servgi/pH-Box-Spring-2025/README.md

Welcome to my pH box project! This is a collection of some of the most significant rescources and products I've used and produced thus far. You can contact me at s.serviagi@gmail.com or gservia@msudenver.edu. Thanks!
