servgi/pH-Box-Spring-2025/2025 URC poster.pdf

# Utilizing Simple Technology to Create an Instrument for Improved pH Measurements

# Grace Servia, Dr. Shailesh Ambre Metropolitan State University of Denver Department of Chemistry and Biochemistry

`

## Background

Hole for on/off
switch with tactile
labels

USB-C port to
easily access QT Py
and code

Sliding drawer
with battery
compartment

Grooves for QT Py and
Audio BFF to sit in

Speaker mount

Grate for sound to
travel through

Holes for wiring
Detector mount

Cuvette Platform

Indicates direction
of detector

Slot for cuvette

Flip cap to enclose
dark chamber

Ridged and tapered lid to
enclose all chambers

## The Grace pH Box Conclusions and Next Steps

## Acknowledgements

## References

Thank you to Dr. Ambre for supporting my idea and giving me a platform to do research. Thank you also to my big brother Jack for letting me borrow his supplies and knowledge. Thanks to the entire MSU Denver Chemistry and Biochemistry department for teaching me, supporting me, sparking my interest in these subjects, and encouraging me every day.

1) 8.6: The pH Concept. Chemistry LibreTexts. https://chem.libretexts.org/Bookshelves/Introductory_Chemistry/Chemistry_for_Allied_Health_(Soult)/08%3A_Properties_ of_Solutions/8.06%3A_The_pH_Concept (accessed 2024-04-25).
2) 6. Acid-Base Indicators. Chemistry LibreTexts. https://chem.libretexts.org/Bookshelves/Physical_and_Theoretical_Chemistry_Textbook_Maps/Supplemental_Modules_(Physical_and_Theoretical_Chemistry)/Equilibria/Acid-Ba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 (accessed 2024-04-25).
3) Amazon.com. https://www.amazon.com/Hydrion-paper-93-Dispenser-Color/dp/B005FYGXUC (accessed 2024-04-25).
4) pH Electrodes. Chemistry LibreTexts. https://chem.libretexts.org/Bookshelves/Analytical_Chemistry/Supplemental_Modules_(Analytical_Chemistry)/Analytical_S ciences_Digital_Library/Courseware/Analytical_Electrochemistry%3A_Potentiometry/05_pH_Electrodes (accessed 2024-04-25).
5) pH Electrode BNC. Vernier. https://www.vernier.com/product/ph-electrode-bnc/ (accessed 2024-04-26).
6) Aristov, M. M.; Moore, J. W.; Berry, J. F. Library of 3D Visual Teaching Tools for the Chemistry Classroom Accessible via Sketchfab and Viewable in Augmented Reality. J. Chem. Educ. 2021, 98 (9), 3032–3037. https://doi.org/10.1021/acs.jchemed.1c00460.
7) American Printing House for the Blind; Hoffmann, R. The SALS App: Making Chemistry Accessible With iOS Devices. JSESD 2019, 22 (1), 1–5. https://doi.org/10.14448/jsesd.11.0005.
8) Kovarik, M. L.; Clapis, J. R.; Romano-Pringle, K. A. Review of Student-Built Spectroscopy Instrumentation Projects. J. Chem. Educ. 2020, 97 (8), 2185–2195. https://doi.org/10.1021/acs.jchemed.0c00404.
9) Qutieshat, A.; Aouididi, R.; Arfaoui, R. Design and Construction of a Low-Cost Arduino-Based pH Sensor for the Visually Impaired Using Universal pH Paper. J. Chem. Educ. 2019, 96 (10), 2333–2338. https://doi.org/10.1021/acs.jchemed.9b00450.
10) ED2023-0025.pdf. https://quimicanova.sbq.org.br/pdf/ED2023-0025 (accessed 2024-04-26).
11) Go Direct® SpectroVis® Plus Spectrophotometer. Vernier. https://www.vernier.com/product/go-direct-spectrovis-plus-spectrophotometer/ (accessed 2024-04-26).
12) Perkinelmer scan lambda 600 cost - Google Shopping. https://www.google.com/search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 tQlQxAdYxAdwAXgAkAEAmAFioAHAAaoBATK4AQPIAQD4AQGYAgOgAsoBmAMAiAYBkgcDMi4xoAf0BQ&sclient=products-cc (accessed 2024-04-26).

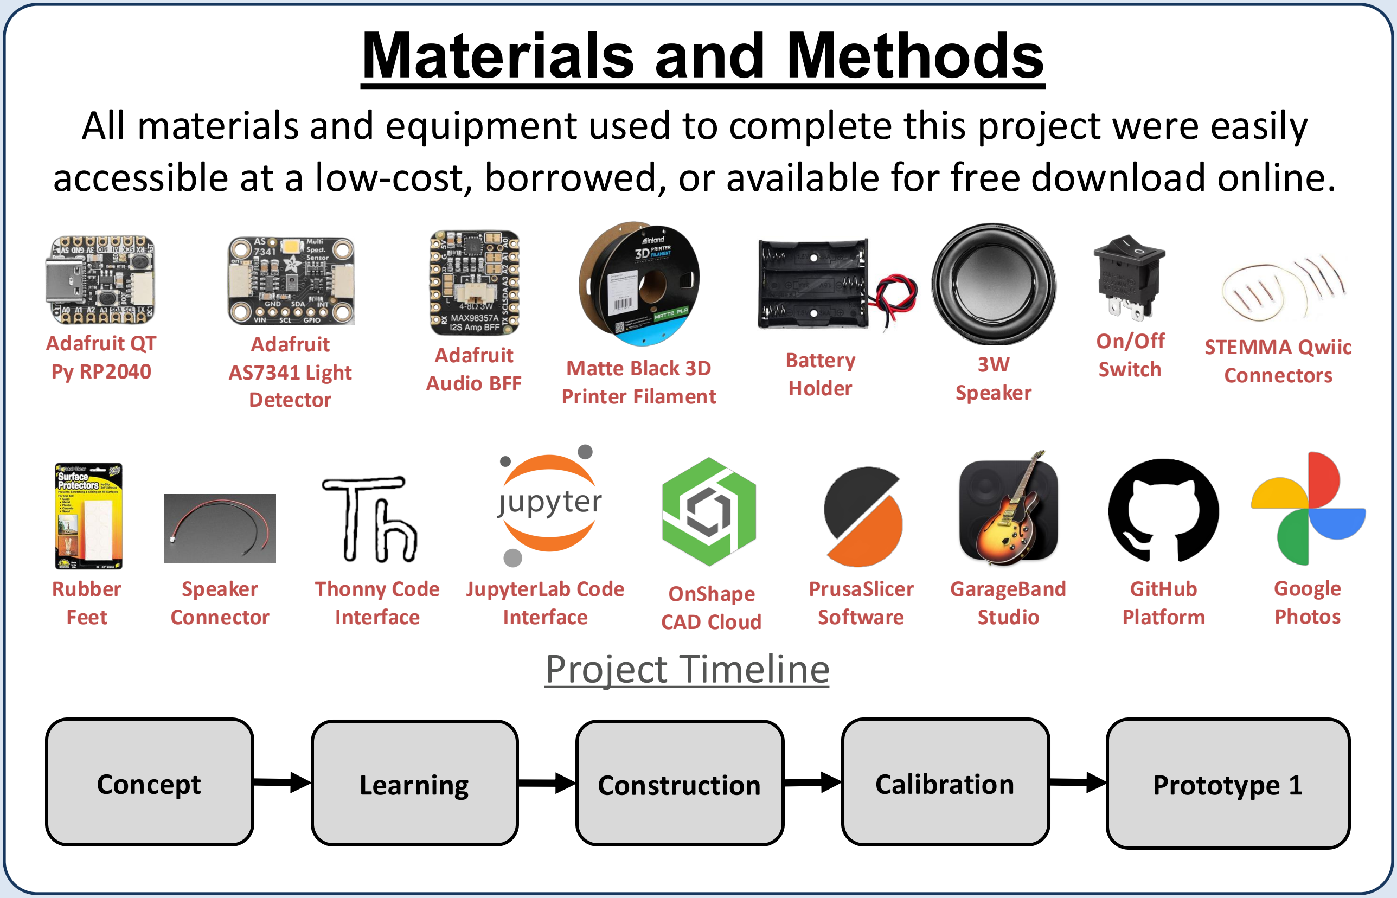
[picture p1: figure]
Materials and Methods; Concept; Learning; Construction; Calibration; Prototype 1; Project Timeline; Thonny Code Interface; PrusaSlicer Software; GitHub Platform; 3W Speaker; Adafruit Audio BFF; Adafruit AS7341 Light Detector; Adafruit QT; Matte Black 3D; Printer Filament; STEMMA Qwiic Connectors; Speaker Connector; On/Off Switch; Rubber Feet; OnShape CAD Cloud; GarageBand Studio; Battery Holder; JupyterLab Code Interface; Google Photos

All materials and equipment used to complete this project were easily accessible at a low-cost, borrowed, or available for free download online.

Figure 3: Finalized CAD designs for Prototype 1.

Figure 4 (left, above): Finalized circuit for Prototype 1.

Figure 5 (left, below): The main loop of the Prototype 1’s code. The yellow comments explain each of the main functions carried out to make the box operate.

Equation 1: Calibration operation generated by the machine learning model. A dot product between the values gathered from each channel and their corresponding calibration coefficients produce a scalar that is then added to an additional calibration constant.

## Calibration

Figure 7a (left): Back of
Prototype 1 including
on/off switch, USB-C
access, and open cap

Figure 7c (right): Interior components of Prototype 1
including circuitry and dark chamber

Figure 7b (middle): Front
of Prototype 1 including
speaker output and
closed cap

Future Prototypes:
- Alternative displays or detectors
- Compact and rounded enclosure
- Manufactured circuit board
- Alternate internal layout or materials

Future Calibrations:
- Larger dataset
- Varying indicator concentrations

Future Applications:
- Organic solvents
- Additional indicators
- Field work
Protype 1: | Compare to:
Price Per Unit: $44.77 Materials Cost: $82.17 Total Project Cost: < ~$400 | Vernier GoDirect Spectrophotometer: $460 ¹¹ PerkinElmer ScanLambda 650: ~ $20000 ¹²

pH is a metric used to describe the concentration of hydrogen ions present in a solution.¹ This value determines the acidity (or basicity) of a scientific sample and plays a key role in chemical, biological, environmental, and industrial applications.¹ Therefore, it is important that accurate and precise methods to measure pH are both scientifically and practically available; however, the two most common methods for pH measurements in undergraduate laboratories leave room for improvement. The aim of this project is to create a simple chemical instrument that produces reliable and standardized pH measurements via spectrophotometry and the direct application of pH indicator dyes. The complete assembly will be affordable, durable, easy to use, and include an accessible output. This project also serves as an example of multidisciplinary research and a proof-of-concept that effective and impactful instrumentation can be developed on small scales.
- pH paper is made from small strips of paper that have been saturated with dyes that change color in response to the proton concentration in a solution.²
- Easy to use, quick, durable, and affordable (~$10 per roll) ³
- Accuracy is reduced by human interpretation error, chemicals present in papers, and degradation
- Inaccessible to blind and colorblind users
- pH probes translate the voltage difference between a reference and test electrode to a pH value and report it digitally. ⁴
- More accurate and accessible than pH paper
- Delicate, bulky, difficult to use, time intensive, and expensive (~$70 and upwards per probe) ⁵
- Both pH paper and pH probes are not designed for use in aqueous mediums
- The design, construction, and implementation of simple instrumentation is a booming subject in the field of chemistry. It improves accessibility in lab settings, offers opportunities to explore sustainable research, and reduces costs.⁶⁻¹⁰

Prototype 1:
✓ Accessible
✓ Yields a standardized pH reading (could still be improved)
✓ Affordable:

Figure 6: To test the calibration, 25% of the dataset (21 readings) was set aside to be compared with values predicted by the model. When plotted against one another, the reserved actual values (orange) and predicted values (blue) follow a close trend.

A linear machine learning model (Equation 1) was developed using the scikit-learn Python library and 81 aqueous pH measurements gathered with a pH probe and universal indicator. The model was generally able to predict a pH value within 1 pH value of an actual measurement.

Figure 1: pH papers’ response to solutions of varying pH

Figure 2: A typical pH probe

## Code

## Circuit

## Enclosure
