servgi/pH-Box-Spring-2025/CAD/lid.stl

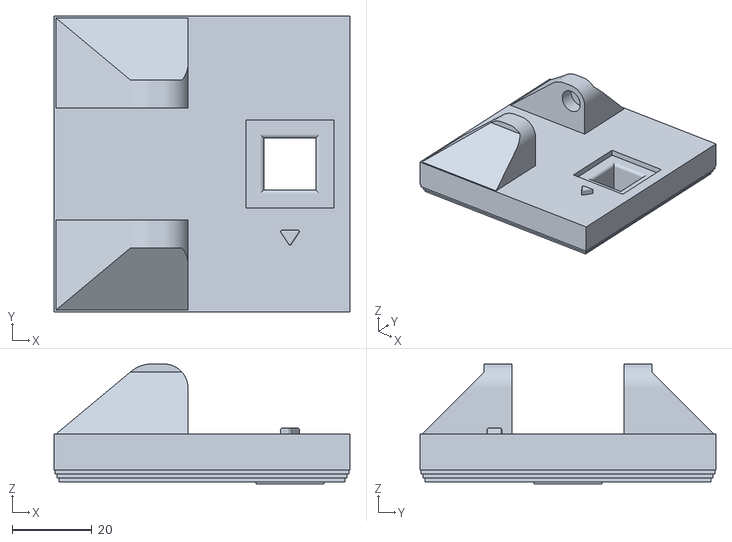
[picture p2: CAD file, 2025-04-24]
CAD/lid.stl
74.0 x 74.0 x 30.0
