servgi/pH-Box-Spring-2025/CAD/bottom.stl

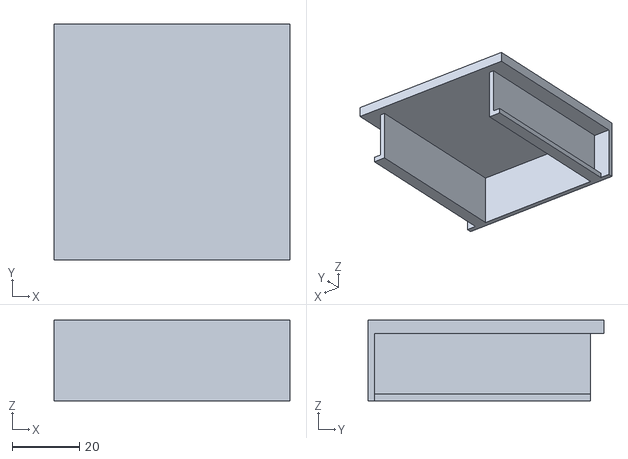
[picture p3: CAD file, 2025-04-24]
CAD/bottom.stl
70.0 x 70.0 x 24.0
