servgi/pH-Box-Spring-2025/CAD/cap.stl

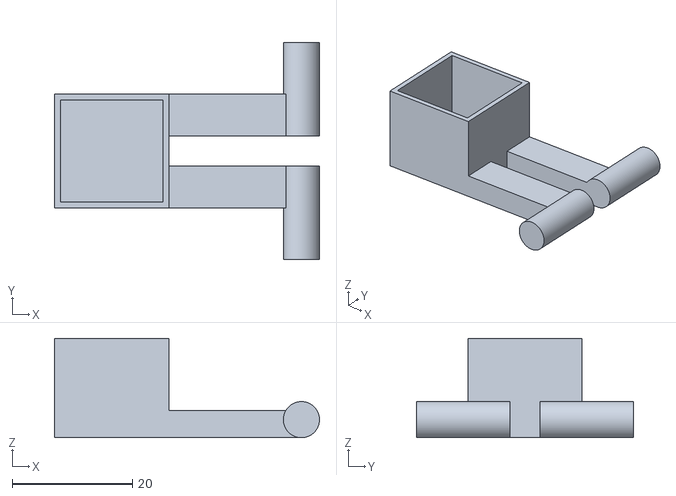
[picture p4: CAD file, 2025-04-24]
CAD/cap.stl
44.0 x 36.0 x 16.5
