servgi/pH-Box-Spring-2025/CAD/component box.stl

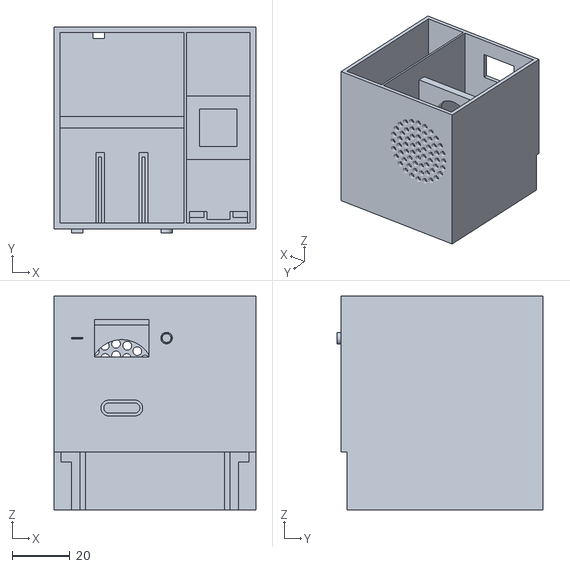
[picture p5: CAD file, 2025-04-24]
CAD/component box.stl
70.0 x 71.5 x 74.0
