servgi/pH-Box-Spring-2025/Calibration/CALIBRATIONtrial2.txt

index,phbox,phprobe,415nm,445nm,480nm,515nm,555nm,590nm,630nm,680nm
83,1.3,4.53,128.0,827.9,703.0,1022.4,1266.6,1310.5,1428.5,738.8
84,1.4,4.16,139.2,855.1,785.0,1203.4,1444.4,1375.5,1490.3,769.5
85,0.9,6.97,94.0,629.0,571.8,891.9,966.2,832.4,935.9,557.6
86,1.3,3.97,126.0,765.7,692.9,1011.6,1254.4,1279.0,1396.4,720.2
87,1.0,8.13,96.9,710.9,609.9,884.0,938.8,803.9,931.0,573.8
88,1.3,3.80,126.0,826.4,681.9,980.9,1217.9,1279.2,1399.0,724.0
89,1.3,8.51,129.0,932.4,786.4,1111.4,1167.3,1036.3,1207.3,728.2
90,1.2,3.66,122.0,793.7,654.2,934.0,1182.3,1267.5,1392.1,717.4
91,1.3,8.76,127.0,887.9,772.0,1059.6,1123.8,1019.8,1198.6,726.6
92,1.3,3.40,128.9,885.3,684.1,980.9,1225.6,1315.0,1427.3,740.0
93,1.2,8.87,120.7,946.1,728.5,984.7,1022.3,959.5,1115.9,696.8
94,1.3,3.20,126.9,793.8,676.2,953.0,1222.0,1304.0,1432.3,738.5
95,1.2,9.15,123.0,881.8,743.2,998.8,1061.3,1003.2,1182.2,727.0
96,1.2,3.04,122.8,796.1,639.7,911.8,1179.2,1283.3,1405.4,723.5
97,1.2,9.30,119.9,858.7,715.3,961.0,1019.9,968.0,1148.2,711.3
98,1.3,2.84,127.0,801.0,673.7,964.1,1241.4,1318.2,1441.2,743.4
99,1.3,9.56,131.3,951.8,779.0,1040.4,1106.3,1073.5,1243.1,747.4
100,1.2,2.66,121.7,746.2,638.4,910.2,1194.2,1265.1,1383.6,711.0
101,1.2,9.78,118.0,901.7,699.5,909.0,958.5,929.5,1090.1,686.8
102,1.4,2.41,135.1,919.5,709.7,1028.6,1329.7,1397.9,1508.3,777.5
103,1.2,10.07,120.0,944.0,712.2,931.9,987.0,966.9,1136.1,705.6
104,1.2,2.17,125.0,790.1,652.1,942.0,1239.4,1313.7,1423.0,736.2
105,1.3,10.23,128.8,952.2,763.0,995.8,1067.2,1050.1,1236.0,747.8
106,1.2,2.02,120.0,735.2,625.4,903.2,1195.9,1257.0,1362.8,703.8
107,1.2,10.62,120.0,920.9,714.5,925.2,1003.7,965.8,1143.3,710.0
108,1.3,1.87,125.7,838.5,645.0,926.6,1231.2,1296.6,1404.0,722.8
109,1.1,10.96,111.9,857.5,666.9,849.0,914.1,893.5,1063.1,668.7
110,1.0,11.21,101.0,720.0,607.2,772.0,845.0,830.0,1003.2,628.8
111,1.4,4.25,135.1,834.1,776.1,1239.3,1441.5,1335.4,1431.1,747.0
112,1.5,4.87,148.2,943.0,863.9,1382.6,1586.6,1437.8,1548.3,808.3
113,1.3,3.81,131.0,806.6,747.0,1196.8,1408.0,1312.9,1412.3,737.7
114,1.5,5.17,146.9,929.4,851.0,1349.5,1546.4,1389.2,1502.1,784.9
115,1.4,3.79,136.0,884.0,775.7,1201.7,1423.1,1367.0,1467.1,760.0
116,1.4,5.41,139.0,892.0,808.8,1283.6,1476.2,1327.0,1438.6,757.8
117,0.9,3.76,93.1,602.0,507.9,743.9,921.5,960.1,1039.2,548.0
118,1.3,5.71,133.9,887.5,787.9,1261.4,1420.7,1269.5,1378.6,742.6
119,1.3,3.65,129.0,819.8,689.0,978.0,1231.0,1327.9,1444.8,744.9
120,1.4,5.89,141.8,908.9,829.0,1326.3,1499.8,1335.4,1451.7,778.4
121,1.3,3.49,126.9,812.3,665.5,942.1,1210.5,1346.9,1471.1,755.5
122,1.4,5.93,137.3,906.1,809.0,1292.5,1456.1,1297.6,1410.4,761.2
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
