servgi/pH-Box-Spring-2025/Calibration/CALIBRATIONtry2.csv

index | phbox | phprobe | 415nm | 445nm | 480nm | 515nm | 555nm | 590nm | 630nm | 680nm
83 | 1.3 | 4.53 | 128.0 | 827.9 | 703.0 | 1022.4 | 1266.6 | 1310.5 | 1428.5 | 738.8
84 | 1.4 | 4.16 | 139.2 | 855.1 | 785.0 | 1203.4 | 1444.4 | 1375.5 | 1490.3 | 769.5
85 | 0.9 | 6.97 | 94.0 | 629.0 | 571.8 | 891.9 | 966.2 | 832.4 | 935.9 | 557.6
86 | 1.3 | 3.97 | 126.0 | 765.7 | 692.9 | 1011.6 | 1254.4 | 1279.0 | 1396.4 | 720.2
87 | 1.0 | 8.13 | 96.9 | 710.9 | 609.9 | 884.0 | 938.8 | 803.9 | 931.0 | 573.8
88 | 1.3 | 3.80 | 126.0 | 826.4 | 681.9 | 980.9 | 1217.9 | 1279.2 | 1399.0 | 724.0
89 | 1.3 | 8.51 | 129.0 | 932.4 | 786.4 | 1111.4 | 1167.3 | 1036.3 | 1207.3 | 728.2
90 | 1.2 | 3.66 | 122.0 | 793.7 | 654.2 | 934.0 | 1182.3 | 1267.5 | 1392.1 | 717.4
91 | 1.3 | 8.76 | 127.0 | 887.9 | 772.0 | 1059.6 | 1123.8 | 1019.8 | 1198.6 | 726.6
92 | 1.3 | 3.40 | 128.9 | 885.3 | 684.1 | 980.9 | 1225.6 | 1315.0 | 1427.3 | 740.0
93 | 1.2 | 8.87 | 120.7 | 946.1 | 728.5 | 984.7 | 1022.3 | 959.5 | 1115.9 | 696.8
94 | 1.3 | 3.20 | 126.9 | 793.8 | 676.2 | 953.0 | 1222.0 | 1304.0 | 1432.3 | 738.5
95 | 1.2 | 9.15 | 123.0 | 881.8 | 743.2 | 998.8 | 1061.3 | 1003.2 | 1182.2 | 727.0
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
